tyecam1/Mechatronic-Walkaide/Initial Designs and Design Specification/Design 3 Sketch.png

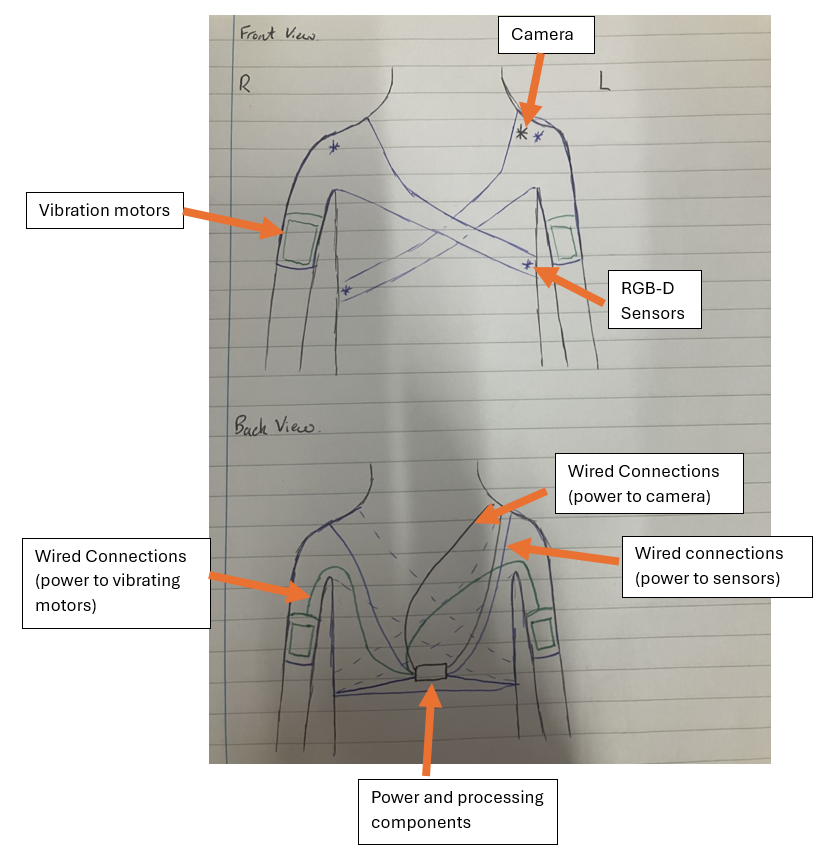
Initial Designs and Design Specification/Design 3 Sketch.png
