tyecam1/Mechatronic-Walkaide/Pictures of Devices/Car Screenshot.png

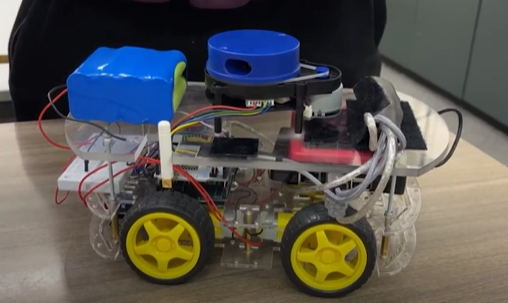
Pictures of Devices/Car Screenshot.png
