tyecam1/Mechatronic-Walkaide/Initial Designs and Design Specification/Design 2 Sketch powerpoint.pptx

The user’s upper arm is pulled back to open the chest towards the desired direction of travel

FRONT

BACK

## Slide 2

The user’s upper arm is pulled back to open the chest towards the desired direction of travel

FRONT

BACK

Lightweight vest

## Slide 3

The user’s upper arm is pulled back to open the chest towards the desired direction of travel

FRONT

BACK

Lightweight vest

Camera/sensors

## Slide 4

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

Storage pouch (battery pack)

FRONT

BACK

Lightweight vest

Camera/sensors

## Slide 5

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

Storage pouch (battery pack)

FRONT

BACK

Lightweight vest

Camera/sensors

Arm loops connected to ropes

## Slide 6

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

Storage pouch (battery pack)

FRONT

BACK

Lightweight vest

Motor driven pulley system

Camera/sensors

Arm loops connected to ropes
