tyecam1/Mechatronic-Walkaide/Initial Designs and Design Specification/Mechatronics Design 1 Animations.pptx

## Slide 2

RGB-D Camera

## Slide 3

Camera

RGB-D Camera

## Slide 4

Camera

RGB-D Camera

Weight, giving instructions for navigation

## Slide 5

Camera

RGB-D Camera

Vest, sitting on the users' shoulders

Weight, giving instructions for navigation

## Slide 6

Camera

RGB-D Camera

Vest, sitting on the users' shoulders

Strapped Connections

Weight, giving instructions for navigation

## Slide 7

Camera

RGB-D Camera

Vest, sitting on the users' shoulders

Strapped Connections

Weight, giving instructions for navigation

Battery Power Pack

## Slide 8

Vest, sitting on the users' shoulders

## Slide 9

Vest, sitting on the users' shoulders

Strapped Connections

## Slide 10

Vest, sitting on the users' shoulders

Strapped Connections

Battery Power Pack

## Slide 11

Camera

Vest, sitting on the users' shoulders

Strapped Connections

Battery Power Pack

## Slide 12

Camera

RGB-D Camera

Vest, sitting on the users' shoulders

Strapped Connections

Battery Power Pack

## Slide 13

Camera

RGB-D Camera

Vest, sitting on the users' shoulders

Strapped Connections

Weight, giving instructions for navigation

Battery Power Pack
