tyecam1/Mechatronic-Walkaide/Pictures of Devices/Devices.docx

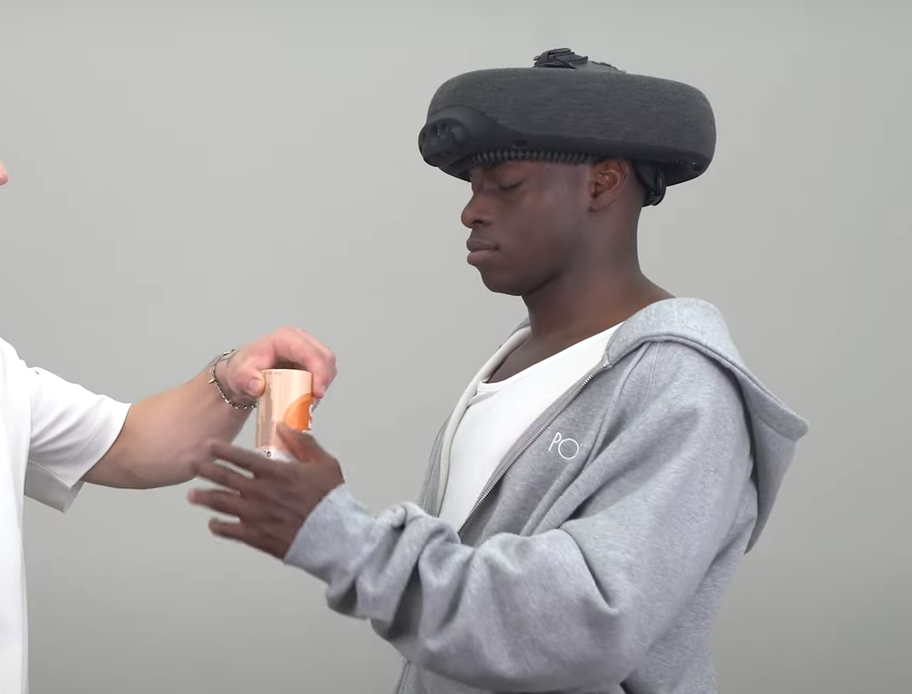
[picture p11: figure]
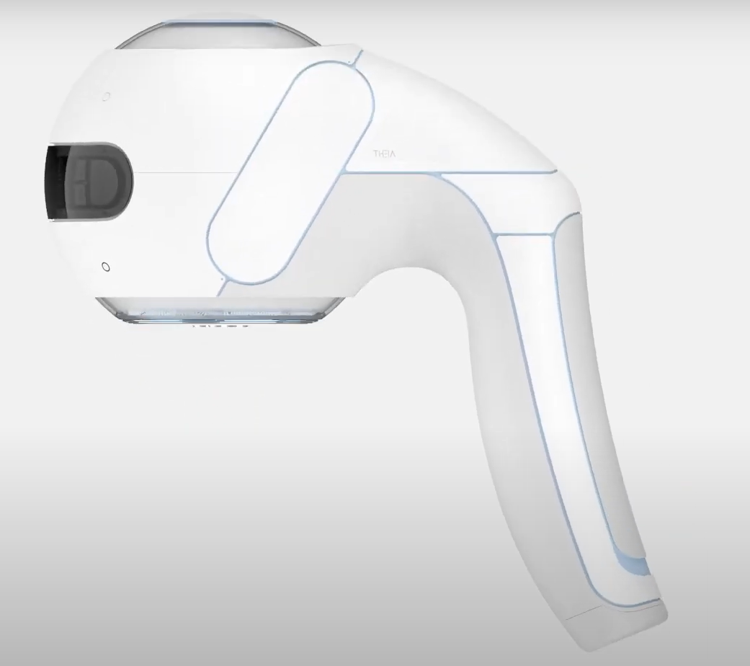
[picture p12: figure]
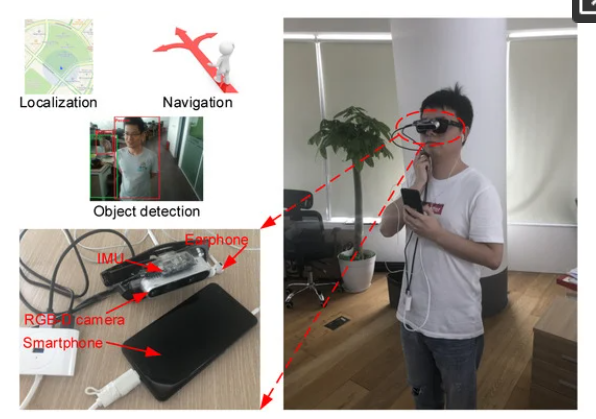
[picture p13: figure]
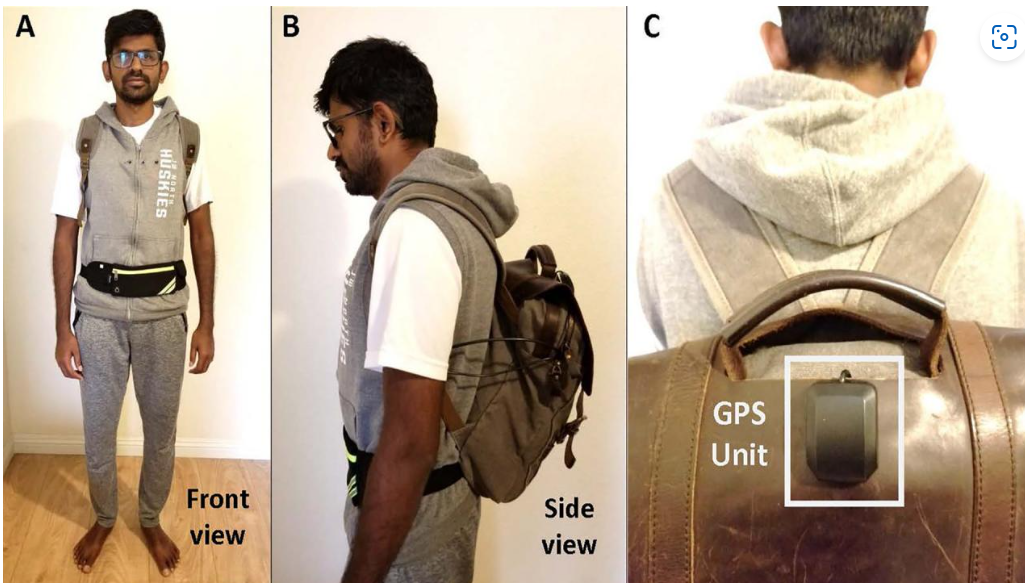
[picture p14: figure]
