tyecam1/Mechatronic-Walkaide/Initial Designs and Design Specification/Design Specification (Blind Walking Aid).xlsx

 |  |  |  | Design 1 |  | Design 2 |  | Design 3 |  | Design 4 |  | Design 5 |  | Design 6
 |  |  |  | Dylan | Sam | Dylan | Sam | Dylan | Sam | Dylan | Sam | Dylan | Sam | Dylan | Sam
 | Description | Weighting | Reasoning
Functional Requirements | Obstacle Detection | 5 |  | 25 | 25 | 25 | 25 | 25 | 25 | 25 | 25 | 25 | 25 | 20 | 15
 | Navigation Assistance | 5 |  | 15 | 15 | 25 | 20 | 15 | 20 | 25 | 25 | 25 | 25 | 20 | 15
 | Wearable Device | 5 |  | 25 | 25 | 25 | 25 | 25 | 25 | 25 | 25 | 25 | 25 | 25 | 25
 | Battery Powered | 3 |  | 15 | 15 | 15 | 15 | 15 | 15 | 15 | 15 | 15 | 15 | 15 | 15
 | Bluetooth Connection | 2 |  | 0 | 0 | 0 | 0 | 0 | 0 | 0 | 0 | 0 | 0 | 0 | 0
 | Detection of all surroundings | 5 |  | 20 | 15 | 20 | 15 | 20 | 15 | 15 | 15 | 20 | 15 | 15 | 15
 | Sensors | 5 |  | 25 | 25 | 25 | 20 | 25 | 25 | 25 | 25 | 25 | 25 | 20 | 15
 | Camera | 5 |  | 25 | 25 | 25 | 20 | 25 | 25 | 25 | 25 | 25 | 25 | 20 | 15
Feedback | Audio | 3 |  | 0 | 0 | 0 | 0 | 0 | 0 | 0 | 0 | 0 | 0 | 0 | 0
 | Haptic | 4 |  | 10 | 10 | 20 | 20 | 15 | 20 | 20 | 20 | 20 | 20 | 20 | 20
 | Force feedback | 5 |  | 0 | 0 | 15 | 15 | 0 | 0 | 0 | 0 | 25 | 25 | 15 | 15
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
