tyecam1/Mechatronic-Walkaide/Initial Designs and Design Specification/Design 1 sketch.png

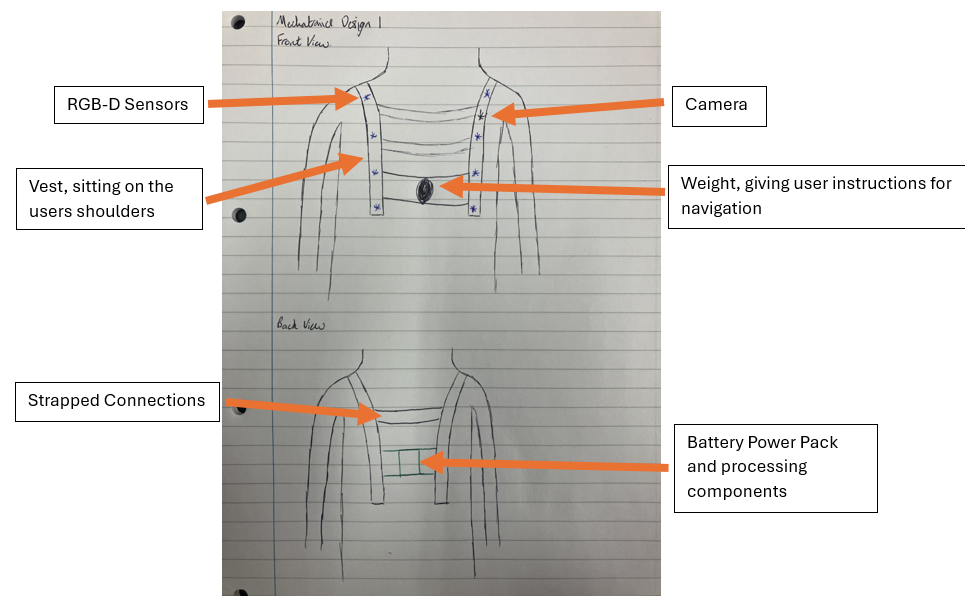
Initial Designs and Design Specification/Design 1 sketch.png
