tyecam1/Mechatronic-Walkaide/Order Forms/Items Ordered Total.xlsx

Item | 29
RGBD Camera | 319.81
Pi 5 | 75.7 |  | Electronics |  | Sensors |  | Power & Cables |  | Motors & Movement |  | Wearable Components |  |  | Category | Total
Arduino Nanos | 88.8 |  | Devices | Prices | Devices | Prices | Devices | Prices | Devices | Prices | Devices | Prices |  | Electronics | 1032.29
Lattepanda Delta 3 | 366 |  | LattePanda Delta 3 | 366 | RGBD Camera | 319.81 | Talentcell 12V/5V Battery | 47.69 | 360 Motors | 13.86 | Shoulder Straps | 29.99 |  | Sensors | 377.85
USB C cables | 42.78 |  | Pi 5 / 8 GB | 75.7 | IMU Arduino Motion Shield | 25.8 | Power Bank for Car | 33.99 | 180 Motors | 29.52 | Webbing Strap | 5.99
Lattepanda Case (Wrong size) | 19.14 |  | Pi 5 / 16GB | 94.62 | 2x Pressure Sensor | 32.24 | DC to USB-C Cables | 8.69 | Spare Motors | 28.12 | Breathable Mesh | 10.87
LattePanda Case | 22.2 |  | Pi 5 Case | 9.66 |  |  | Micro USB Wires | 10.89 | Dynamixel motors | 222.77 | Belt | 16.99 |  | Power Cables | 196.77
IMU motion shield | 25.8 |  | Pi 5 Heat Sink Case | 16.4 |  |  | Ethernet Cables | 15.42 |  |  | Felt Bads | 5.99 |  | Motors & Movement | 71.5
Double shoulder support | 32.99 |  | 9x Arduino Nano 33 BLE | 205.8 |  |  | USB-C Cables | 42.78 |  |  | Double shoulder support | 32.99 |  | Wearable Components | 267.79
Posture corrector | 17.99 |  | LattePanda Case (Right & Wrong) | 41.34 |  |  | Cable Ties | 16.15 |  |  | Posture corrector | 17.99
Action camera harness | 16.99 |  |  |  |  |  | Heat Shrink | 21.16 |  |  | Action camera harness | 16.99
360 Motor (4) | 13.86 |  |  |  |  |  |  |  |  |  | Gimble | 129.99
180 Linear Motor (4) | 29.52 |  | Total | 809.52 | Total | 377.85 | Total | 196.77 | Total | 294.27 | Total | 267.79
Micro USB wires | 10.89
Talentcell 12V & 5V Battery | 47.69
DC to USB-C cables | 8.69
Power Bank for Car | 33.99
Webbing Strap | 5.99
Shoulder Straps | 29.99
Breathable Mesh (Green) | 10.87
Belt | 16.99
Felt Pads | 5.99
Pi5 Case | 9.66
5x nanos | 117
2x Pressure sensor | 32.24
Ethernet | 8.82
cable ties | 16.15
heat shrink | 21.16
spare motors | 28.12
Ethernet Cables / Networking Cables CAT 6A Shielded RJ45 - 2ft | 6.42
Raspberry Pi 5 | 94.62 | 523-MP6A45SNNW002 |  | Ethernet Cables / Networking Cables CAT 6A Shielded RJ45 - 2ft |  |  |  |  |  | 1 |  | 1 | 6.42 inc VAT
Pi 5 Heat Sink Case | 16.4 | 358-SC1113 |  | Single Board Computers Raspberry Pi 5/16GB |  |  |  |  |  | 1 |  | 1 | 94.62 inc VAT
Gimble | 129.99 | 426-FIT0991 |  | Raspberry Pi Accessories Aluminum Argon NEO 5 BRED Case with Built-in Cooling Fan (Compatible with Raspberry Pi 5) |  |  |  |  |  | 1 |  | 1 | 16.4 inc VAT
Dynamixel motors | 222.77
Total | 1946.02
