tyecam1/Mechatronic-Walkaide/Order Forms/Mechatronics Order Form - Amazon.xlsx

Sheet: Requisition
CARDIFF UNIVERSITY
PURCHASE REQUISITION
INTERNAL USE ONLY |  |  |  |  |  |  |  |  |  |  |  | THIS DOCUMENT IS NOT AN ORDER
DATE: |  |  | 2025-02-28 |  |  |  |  | Oracle Purchase Order no. |  |  |  |  |  |  |  |  |  | office use only
 |  |  |  |  |  |  |  | Input By:
SUPPLIER NAME AND ADDRESS |  |  |  |  |  |  |  | DELIVERY DETAILS
NAME: |  | Amazon UK |  |  |  |  |  | DELIVER TO PREFIX |  |  |  |  | Trystan Barnett
ADDRESS: |  | 60 Holborn Viaduct |  |  |  |  |  | DELIVER TO: |  |  |  |  | Cardiff School of Engineering
 |  | London |  |  |  |  |  |  |  |  |  |  | Queen's Building
 |  | United Kingdom |  |  |  |  |  |  |  |  |  |  | 14-17 The Parade
 |  |  |  |  |  |  |  |  |  |  |  |  | Newport Road
POST CODE: |  | EC1A 2FD |  |  |  |  |  |  |  |  |  |  | Cardiff, Wales
SUPPLIER NOTES: |  |  |  |  |  |  |  |  |  |  |  |  | CF24 3AA
 |  |  |  |  |  |  |  | REQUESTOR NAME: |  |  |  |  | Trystan Barnett
 |  |  |  |  |  |  |  | TEL No: |  |  |  |  | 07949238377
TICK IF SUPPLIER IS INTERNAL |  |  |  |  |  |  |  | EMAIL : |  |  |  |  | barnettt@cardiff.ac.uk
 |  |  |  |  |  |  |  | REQUIRED DELIVERY DATE: |  |  |  |  | ASAP
 |  |  |  |  |  |  |  |  |  |  |  |  |  | PROJECT INFORMATION REQUIRED
PRODUCT CODE/CATEGORY CODE | DESCRIPTION OF GOODS OR SERVICES: |  |  |  | UOM | QTY | UNIT PRICE |  | GL CODE (Cost Centre/Analysis/Account) or PROJECT NUMBER |  |  |  |  | EC PROJECT Yes or No | TASK NO - (EC Project Type) | EXPENDITURE TYPE | EXPENDITURE ORGANISATION | RECOVERABLE PROJECT Yes or No | TOTAL
B072HR211P | TalentCell Rechargeable 36W 12V/3000mAh Lithium Ion Battery Pack, 12V/5V Dual Output External Battery Power Bank with Charger for LED Strip, Tape Light, CCTV Camera and more, Black |  |  |  | 1 | 1 | £52.99 |  | AB23613010 |  |  |  |  | No |  |  |  | No | £52.99
B0DKY2MCV7 | Witrn USB C to DC PD Trigger Power Charge Cable,[PD Fast Charging, Durable PVC, Tangle-Free, Anti-Breakage] Compatible with Router, laptop etc DC Power Device (5.5mm/2.5mm, 2.1mm) 9V, 12V, 15V, 20V |  |  |  | 1 | 1 | £13.99 |  | AB23613011 |  |  |  |  | No |  |  |  | No | £13.99
B0D8L124BY | ASPERX 65W 20000mAh Power Bank Fast Charging, Laptop Portable Charger with Smart Digital Display, USB C PD Battery Pack for iPhone 16/15/14/13, Samsung Galaxy, Dell, iPad, AirPods, etc. |  |  |  | 1 | 1 | £33.99 |  | AB23613012 |  |  |  |  | No |  |  |  | No | £33.99
B06XDCRQL7 | Bujingyun 1 Inch Wide Black Nylon Heavy Webbing Strap, 10 Yards |  |  |  | 1 | 1 | £5.99 |  | AB23613013 |  |  |  |  | No |  |  |  | No | £5.99
B08HGRLK73 | Universal Adjustable Waterproof Replacement Shoulder Straps Golf Bag Backpack Straps Replacement |  |  |  | 1 | 1 | £23.99 |  | AB23613014 |  |  |  |  | No |  |  |  | No | £23.99
B0CCKQX1WC | 1MX1.6M Breathable Sandwich Mesh Three Layer 3D Cloth Sandwich Mesh Fabric Elastic Mesh Cloth Air Bed Fabric Sofa Raw Material (Dark Green) |  |  |  | 1 | 1 | £10.87 |  | AB23613015 |  |  |  |  | No |  |  |  | No | £10.87
B0CYQ5HHH3 | Azarxis Tactical Battle Belt Heavy Duty Molle Military Nylon Waist Belts Adjustable for Men Women Airsoft Shooting Paintball Hunting Outdoor Sports |  |  |  | 1 | 1 | £16.99 |  | AB23613016 |  |  |  |  | No |  |  |  | No | £16.99
B0C2Z8BVKT | teeppo Furniture Pads Floor Protectors, Felt Pads for Furniture Feet 3x1M(10cm + 5cm + 2cm), Chair Leg Floor Protectors with 4mm Thick, Self-Adhesive, Anti-Scratches and Reduce Noise, Black |  |  |  | 1 | 1 | £5.99 |  | AB23613017 |  |  |  |  | No |  |  |  | No | £5.99
ARE THE ITEMS CLASSED AS HAZARDOUS? |  |  |  | N |  | IS THIS ORDER ZERO RATED FOR VAT? |  |  |  |  | Y |  |  |  |  |  | NET |  | £164.80
 |  |  |  |  |  |  |  |  |  |  |  |  |  |  |  |  | VAT |  | £0.00
IF HAZARDOUS, HAS THE APPROPRIATE PAPERWORK |  |  |  |  |  | IF YES, SELECT FROM DROPDOWN |  |  |  |  | CU Exempt |  |  |  |  |  | DELIVERY
BEEN COMPLETED i.e. RISK ASSESSMENTS AND COSHH FORMS? |  |  |  |  |  |  |  |  |  |  |  |  |  |  |  |  | TOTAL |  | £164.80
ONCE THIS FORM HAS BEEN COMPLETED, PLEASE EMAIL THROUGH TO YOUR SCHOOL / DIVISION ORDERING EMAIL ACCOUNT.
THE BUDGET HOLDER SHOULD BE CARBON COPIED ON THE EMAIL FOR THEIR RECORDS
AUTHORISATION-Requisition Approver |  |  |  | SIGN |  |  |  | PRINT NAME |  | Rhys Pullin
* Please provide details of 3 quotes (If requistion value is greater than £500)

Sheet: VAT Guidelines
VAT Treatment fields and Possible Uses
Rate Name | Rate Value | Example of Purchases to which it applies | Additions
*CU Standard | 20.00% | This is the default rate that Oracle applies to goods or services provided by UK Suppliers which are VAT Registered.
CU Exempt | - | Eg applies to bank charges, Rail fares and Flights
CU Standard Temp | 17.50% | Invoices processed without Oracle order before 31 December 2009
CU Zero Other | 0% | books, journals, certain foodstuffs
CU Outside Scope | -
CU Services Performed Overseas | 20.00% | E-journal packages and other services purchased from overseas
CU Charity Ads Zero | 0% | purchases complying with VAT Notice 701/58 | A zero rating certficate is attached to the PO
The following options are exclusive to Medical Related Research and Training
CU Equipment Zero | 0% | purchases complying with VAT Notice 701/6 | A zero rating certficate is attached to the PO
CU Reagents Zero | 0% | purchases of advertising for staff or students under VAT Act 1994 Zero Rate Group 15 | A zero rating certficate is attached to the PO
This is not an exhaustive list of uses
Please direct any queries to vat@cardiff.ac.uk
