tyecam1/Mechatronic-Walkaide/viva/Final Risk Registers.xlsx

Project Risk Register
ID | Risk Description | Likelihood | Impact | Severity | Mitigating action | Progress on action | Severity post mitigations
1 | Technological complexity | 4 | 4 | 16 | Build the design in stages to understand technology gradually | Built first working prototype of the device | 1
2 | Insufficient budget | 3 | 5 | 15 | Buy most critical equipment and log purchasing | Purchased items including spares within budget | 4
3 | Resource constraints | 2 | 5 | 10 | Design the device considering budget and available resources | Purchased all items including spares | 4
4 | Ethical concerns | 5 | 2 | 10 | Conduct ethical impact assesment | Done ethical assesment and approved | 1
5 | Other commitments limiting progress | 4 | 3 | 12 | Pre-plan work considering other commitments and share the workload | Pre-planned considering other deadlines and have split into subteams | 6
6 | Unforseen Illness / Issue | 3 | 4 | 12 | Pre-plan workload and include contingency in the planning process | Taken an organised approach to work highlighting key progress checkpoints | 4
7 | Lack of clear direction | 2 | 4 | 8 | Create a clear project plan / gantt chart to ensure swift timely progress | Made ganttt chart and stuck to plan getting work done in time | 4
8 | Project timeline delay including ordering etc. | 3 | 5 | 15 | Order early and ensure that there is clear communication of these issues | Continuous communication throughout project and ordering as soon as possible | 4
 |  |  |  |  |  |  |  | Likelihood | 5 | 5 | 10 | 15 | 20 | 25
 |  |  |  |  |  |  |  |  | 4 | 4 | 8 | 12 | 16 | 20
 |  |  |  |  |  |  |  |  | 3 | 3 | 6 | 9 | 12 | 15
 |  |  |  |  |  |  |  |  | 2 | 2 | 4 | 6 | 8 | 10
 |  |  |  |  |  |  |  |  | 1 | 1 | 2 | 3 | 4 | 5
 |  |  |  |  |  |  |  |  |  | 1 | 2 | 3 | 4 | 5
 |  |  |  |  |  |  |  |  | Impact
Health & Safety Risk Register
ID | Risk Description | Likelihood | Impact | Severity | Mitigating action | Progress on action | Severity post mitigations
1 | Electricution | 2 | 5 | 10 | Do electrical work in the lab with a technician there and properly set-up equipment | Everyone solder trained and electrical work is done within the electronics lab on proper equipment | 4
2 | Fire from batteries | 2 | 5 | 10 | Use protective casing for batteries, charge them properly and handle them safely | Proper battery casing supplied alongside tested chargers to ensure that the batteries are safe | 5
3 | Short circuits | 3 | 4 | 12 | Clearly label wires and use colour coding conventions to prevent that | Wires colour coded and labelled to prevent issue | 6
4 | Lone working for extended periods | 4 | 3 | 12 | Try and limit working hours to a certain point be open and honest with team | Working hours limited and tried to balance work load | 6
5 | Stress | 4 | 4 | 16 | Work for sensible time periods and be open and honest with workload | Stress very likely but attempting to share the load and stay open with the team | 8
6 | Manual handling | 3 | 4 | 12 | Make sure everyone knows proper handling technique when lifting large objects | Reduced the need for manual handling alongside people knowing technique | 4
