tyecam1/Mechatronic-Walkaide/Testing Data and Questionnaire Responses/Compass testing Questionnaire Responses/Post Test Questionnaire (Compass Oscar).docx

Walk Aid Questionnaire

#### Tester: User

Haptic feedback method: Compass

#### 1. General Usability

1. How easy was it to understand how the device works? (1 - Very difficult, 5 - Very easy)

3 – Difficult at first and for a while does take a lot of practice but once practiced easy

2. Did you feel confident using the device? (Yes / No / Somewhat)

Yes (After a while)

3. How intuitive was the haptic feedback in guiding you through obstacles? (1 - Not intuitive, 5 - Very intuitive)

4 – Some improvements to be made maybe between slight right / full right (or left)

#### 2. Haptic Feedback Effectiveness

4. Were the haptic signals clear and distinguishable from each other? (Yes / No / Somewhat)

Somewhat

5. How quickly did you adapt to the haptic feedback? (1 - Took a long time, 5 - Instantly adapted)

3

6. Did the intensity or pattern of the feedback help you understand the direction or distance of obstacles? (Yes / No / Somewhat)

Somewhat

7. Did you ever feel confused about what the haptic signals were trying to indicate? (Yes / No / Sometimes)

Sometimes

#### 3. Comfort & Wearability

8. How comfortable was the device to wear? (1 - Very uncomfortable, 5 - Very comfortable)

4 – after a long time slight discomfort

9. Did the device feel too bulky, too tight, or cause any discomfort? (Yes / No / Somewhat)

No (very minor)

10. How long do you think you could comfortably wear this device? (Less than 10 mins / 10-30 mins / 30 mins - 1 hour / More than 1 hour)

More than 1 hour (wore it for a full battery life)

#### 4. Performance in Obstacle Navigation

11. Did the device help you avoid obstacles effectively? (Yes / No / Somewhat)

Yes

12. Did you ever feel unsafe or unsure while using the device? (Yes / No / Sometimes)

No (at first yes)

#### 5. Additional Feedback

14. What improvements would you suggest for the haptic feedback system?

Make it more intuitive instantly.

15. Were there any moments where the device did not perform as expected? If so, please describe.

Sometimes was indecisive but quickly fixed itself after turning.

16. Would you feel comfortable using this device in an unfamiliar environment? (Yes / No / Maybe)

Maybe

17. What room (if either) did you feel more confident with the systems commands in?

(Room A/Room B/Neither)

Room A

18. Any other comments or suggestions?
