tyecam1/Mechatronic-Walkaide/Testing Data and Questionnaire Responses/WalkAidQuestionnaireSUMMARY.xlsx

Tester Name | Haptic Feedback Method | Q1: Ease of Use (1–5) | Q1: Confidence | Q1: Intuitive Feedback (1–5) | Q2: Signals Clear? | Q2: Adapt Speed (1–5) | Q2: Feedback Clarity | Q2: Signal Confusion? | Q3: Comfort (1–5) | Q3: Bulk/Discomfort | Q3: Wear Time | Q4: Helped Avoid Obstacles? | Q4: Felt Unsafe? | Q5: Feedback Suggestions | Q5: Unexpected Issues | Q5: Use in Unfamiliar Place? | What room did you prefer? | Q5: Other Comments
Person 1 | Compass | 3 | Yes | 4 | Somewhat | 3 | Somewhat | Sometimes | 4 | No | Over 1 hour | Yes | No (at first yes) | Make more intuitive | Sometimes indecisive | Maybe | Room A
Person 1 | Pulley | 1 | No | 1 | Somewhat | 2 | Somewhat | Yes - often | 3 - had to adjust device to make it work | Somewhat | Over 1 hour | No | Yes (unsure) | More adjustable | Yes | No | Room A
Person 2 | Compass | 3 | Somewhat | 3 | Somewhat | 3 | No | Sometimes | 4 | No | Over 1 hour | Somewhat | No | Increase pressure | Yes | Maybe | Room A
Person 2 | Pulley | 4 | Yes | 4 | Somewhat | 4 | Yes | Someimes | 4 | No | Over 1 hour | Yes | No | in between commands | Not really | Maybe | Room A
Person 3 | Compass | 4 | Somewhat | 3 | Yes | 4 | Yes | No | 3 | No | Over 1 hour | Yes | Sometimes | More force | 360 loops | Maybe | Room A
Person 3 | Pulley | 5 | Yes | 4 | Somewhat | 4 | Somewhat | No | 4 | No | Over 1 hour | Yes | No | More force | One pull stronger | Yes | Room A
Person 4 | Compass | 4 | Yes | 4 | Yes | 4 | Yes | No | 5 | No | Over 1 hour | Somewhat | No | More force | 360 loops | Yes | Room A
Person 4 | Pulley | 3 | Somewhat | 2 | Somewhat | 3 | No | Yes - often | 5 | No | Over 1 hour | No | Yes | Separate forward force - not pull both | Yes | No | Room A | Left and Right was very clear, but had no confidence in forward movement
