tyecam1/Mechatronic-Walkaide/Testing Data and Questionnaire Responses/Risk register for project.pdf

ID | Risk Description | Likelihood | Impact | Severity | Mitigating
action | Progress on

action
1 | Insufficient market research | 3 | 5 | 15 | Research review literature | Completing literature research
2 | Limited budget

4

5 | 20 | Buy critical/expensive equipment first

Ordered camera

3 Resource constraints

2

5 | 10 | Design the device for available resources

Purchased camera

4 | Insufficient user feedback | 3 | 5 | 15 | Experiential simulation throughout the design process | Plan to test on subjects
5 | Competition in the market | 3 | 4 | 12 | Design a new product | Th orough market research – ensure unique design
6 | Ethical concerns | 2 | 5 | 10 | Conduct ethical impact assessment | Plan to conduct IA
7 | Lack of clear vision | 2 | 4 | 8 | Create a clear project plan with milestones and goals | Structured plan for the project
8 | User ergonomics | 2 | 4 | 8 | Test using a diverse range of people + CAD simulations | Scored devices against design specifications
9 | Environmental factors | 4 | 1 | 4 | Dispose of batteries properly, make the device rechargeable | Design device incorporating rechargeable battery
1 0 | Technological comple xity | 3 | 4 | 12 | Use a modular design prototype to understand the technology | Practiced mapping a room using robot car
1 1 | Project timeline delay | 4 | 5 | 2 0 | Identify bottlenecks early – ordering equipment | Gantt chart followed
1 2 | Regulatory compliance | 3 | 5 | 15 | Research laws, policies and regulations | Following ISO 14971
1 3 | User safety | 2 | 5 | 10 | Rigorously test the device and include a fail -safe mechanism | Designed products with user safety in mind
1 4 | Electrical safety issues | 3 | 5 | 15 | Comply with safety standards, safety testing, work in electrical lab | Lab induction competed

5

5 | 10 | 15 | 20 | 25
4 | 4 | 8 | 12 | 16 | 20
3

3

6

9 | 12 | 15
2

2

4

6 | 8 | 10
1 | 1 | 2 | 3 | 4 | 5
| 1 | 2 | 3 | 4 | 5

## Likelihood

## Impact
