tyecam1/Mechatronic-Walkaide/Initial Designs and Design Specification/Design 2 sketch.pdf

FRONT | BACK

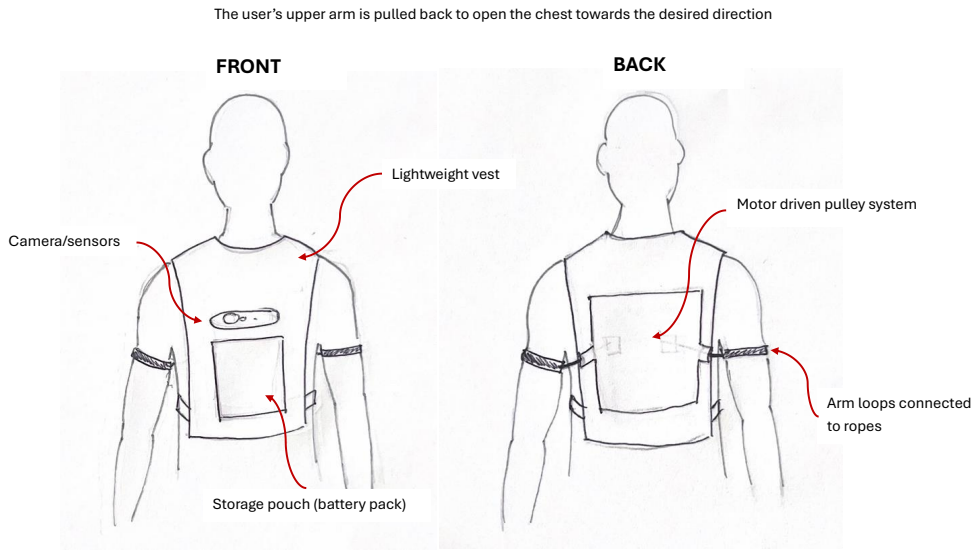
[picture p16: page 1]
Camera/sensors; Lightweight vest

The user’s upper arm is pulled back to open the chest towards the desired direction

Motor driven pulley system

Arm loops connected
to ropes

Storage pouch (battery pack)
