tyecam1/Mechatronic-Walkaide/Initial Designs and Design Specification/Designs 2,5,6.pdf

FRONT | BACK

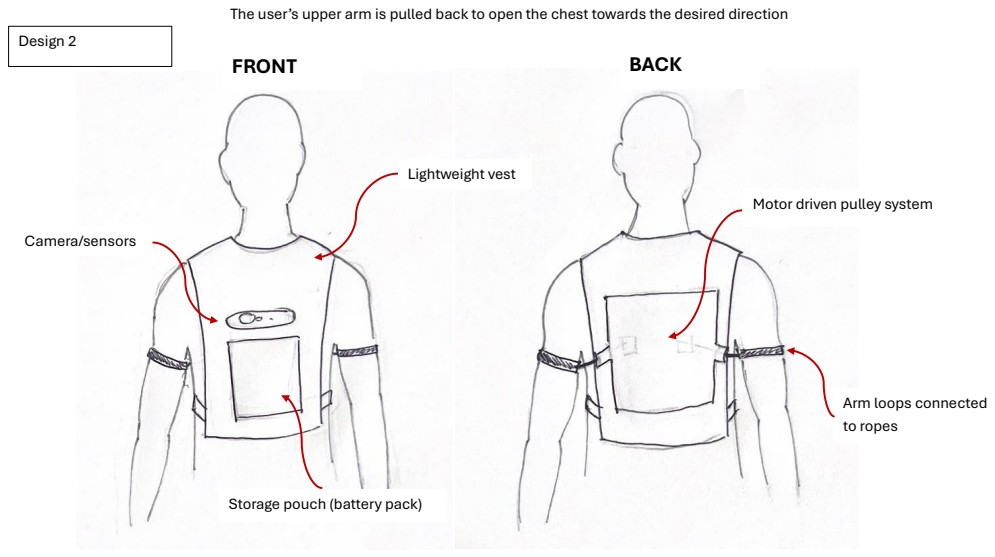
[picture p17: page 1]
Camera/sensors; Lightweight vest; Design 2

The user’s upper arm is pulled back to open the chest towards the desired direction

Motor driven pulley system

Arm loops connected
to ropes

Storage pouch (battery pack)

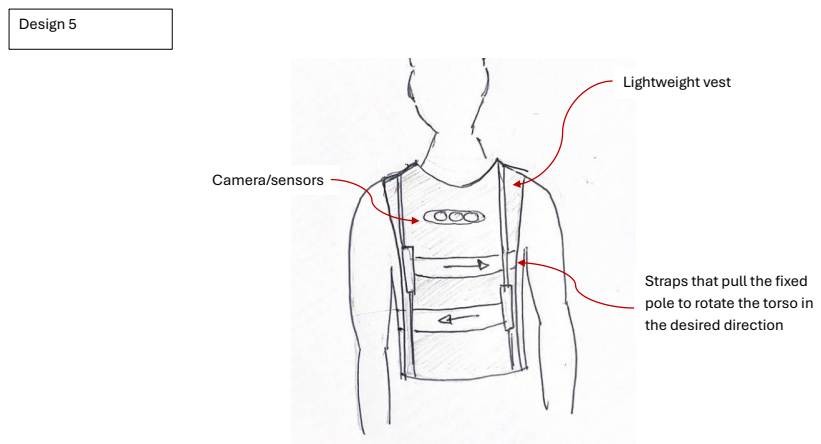
[picture p18: page 2]
Camera/sensors; Lightweight vest; Design 5

Straps that pull the fixed
pole to rotate the torso in
the desired direction

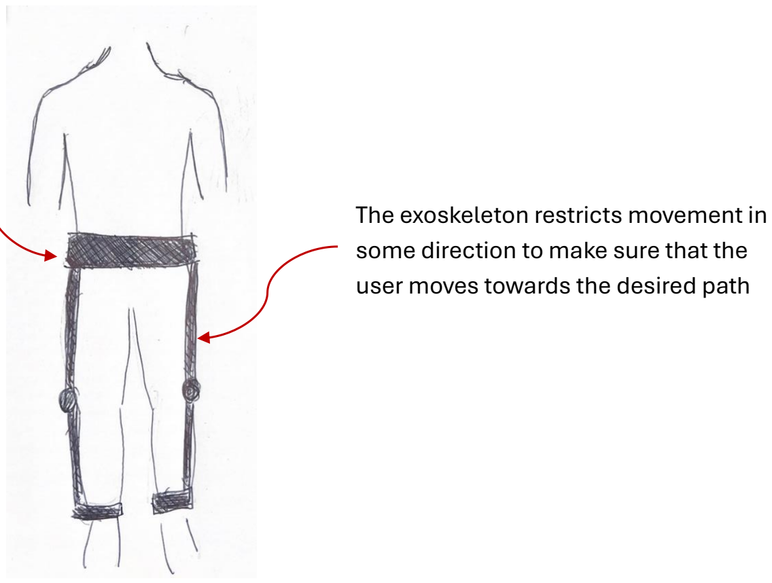
[picture p19: figure]
The exoskeleton restricts movement in some direction to make sure that the user moves towards the desired path

Exoskeleton

Design 6
